EugeneCarlo/Mushsynth-8_voice_drone_synth/How_it_works/README.MD

Hello.<br>
I made a polyphonic synth from improvised and cheap parts.<br>
It came out musically enough.<br>
Now I am often asked to build, but I'm not interested, so I posted the entire project for self-assembly.

Mushsynth-8

This is a polyphonic subtractive synthesizer for 8 voices.

Each voice is a monophonic subtractive synthesizer, parallelly combined into a common low-pass filter and has on board:

An oscillator with adjustable pitch and switchable waveform (Triangle/Square)<br>
An LFO with speed and depth controls to modulate the pitch of the oscillator.<br>
An envelope generator with attack and decay speed adjustments to control the VCA.<br>
Individual volume control for each voice.<br>
To control the envelope generator, capacitive sensors are used, which can operate in two modes (hold or momentary).<br>
Eight such voices are combined into a single low-pass filter and delay. I have also added an independent knob for adding white noise.<br>
Each voice can be controlled by CV/GATE which is set to each voice.<br>

Technicial Specifications:
+ 8 Polyphony
+ 8 Analog VCO
+ 2 Waveforms VCO
+ 8 Analog LFO (Speed/Depth)
+ 8 Analog Envelope (Attack/Decay)
+ 8 Analog VCA
+ 8 Channel Mixer
+ 8 Sensor touch panel
+ 1 White noise generator
+ 1 Analog LP Filter
+ 1 Delay PT2399
+ 8 CV inputs
+ 8 GATE inputs
+ Can work with adapter 9V
+ Mono Output (6.3mm jack)
+ Circuit banding area (bread board)

The synthesizer consists of 3 PCB on which all components are placed.<br>
The circuit is completely analog, so a lot of components came out (about 750)

Mushsynth-8

Below is some information about the circuit that I used.

For sensors, I used TTP223 microcircuits, because they are affordable and can work in two modes (hold and momentary)<br>
You can set the sensitivity of the capacitors<br>
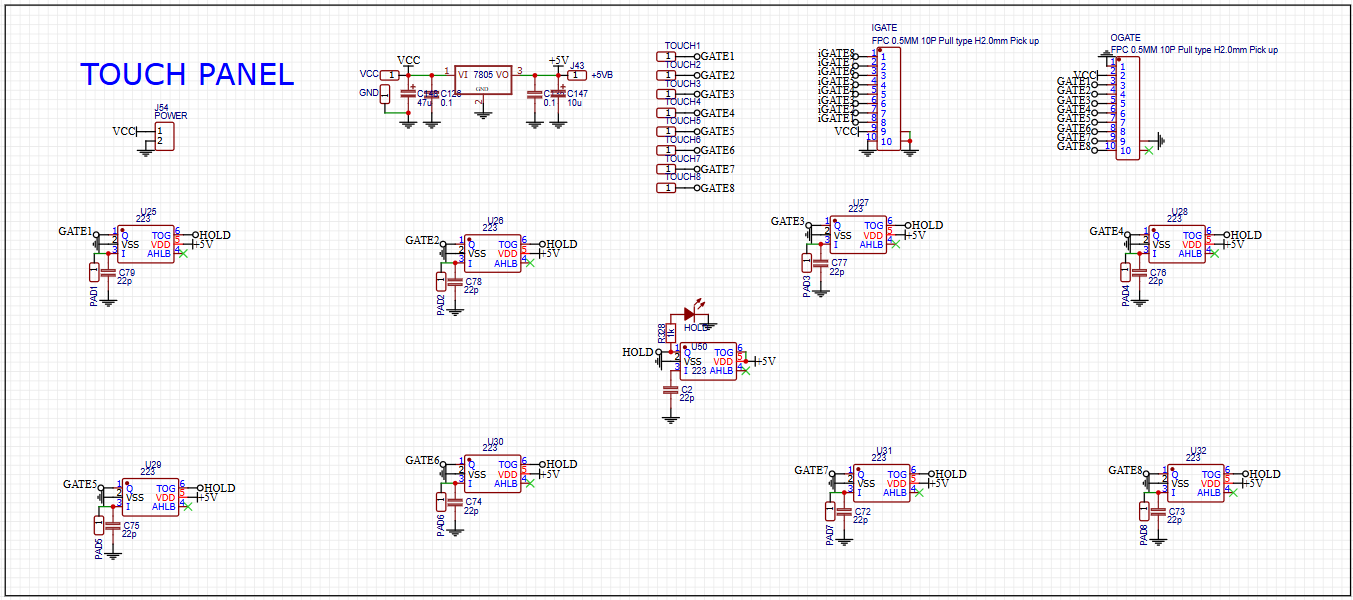
[picture p5: Schematic/Touch.png]
Touch


The VCO was made on one OpAmp LM358, according to some of the simplest schemes from the Internet, but it works well and gives out two signals (a triangle and a square)

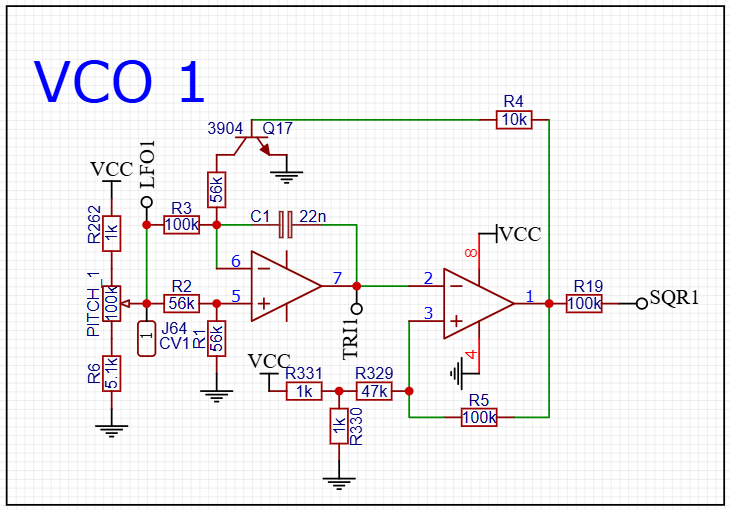
[picture p6: Schematic/VCO.png]
VCO

To modulate the pitch, I made an LFO.<br>
I also used LM358 and added a speed indication through a transistor.

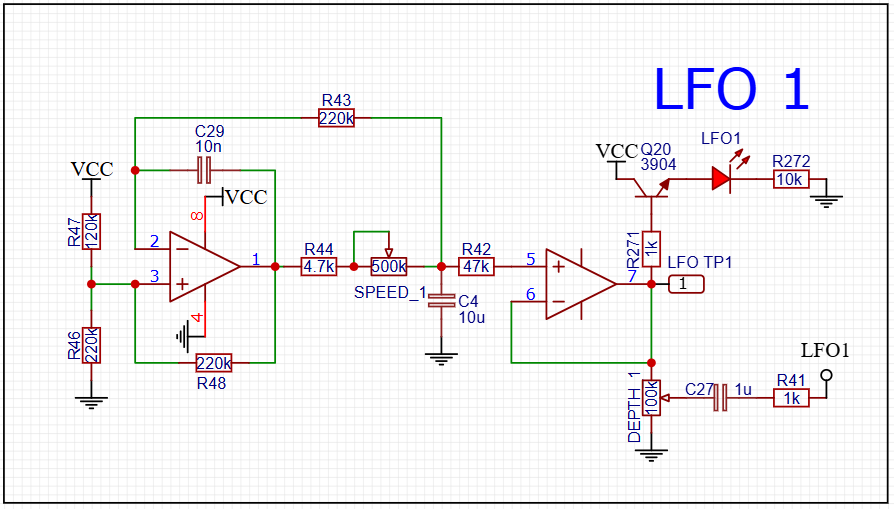
[picture p7: Schematic/LFO.png]
LFO

Then the signal is sent to the VCA, I could not find a suitable working example that would work well from + 9v, so I had to experiment, but I was satisfied with the result, this circuit works stably.<br>
I used lm13700 because they are clear to me and work in different voltage ranges.

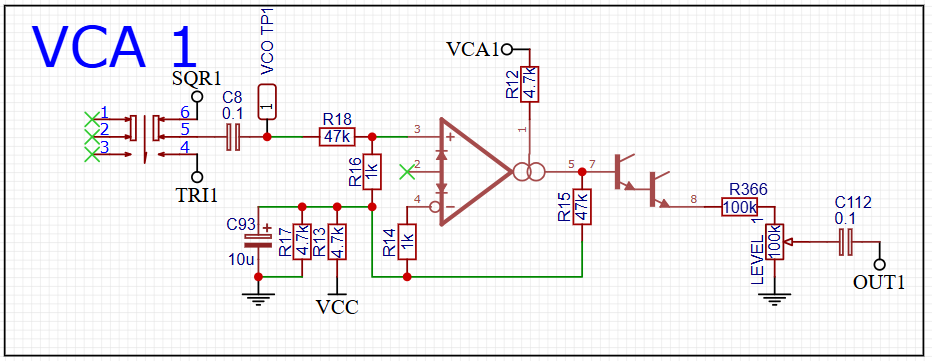
[picture p8: Schematic/VCA.png]
VCA

To control the VCA, I needed an envelope generator, I also decided to use the lm358 and made a fairly classic circuit, but I used only a single-polar supply.<br>
I also added an indication of operation through a transistor, as in the LFO.

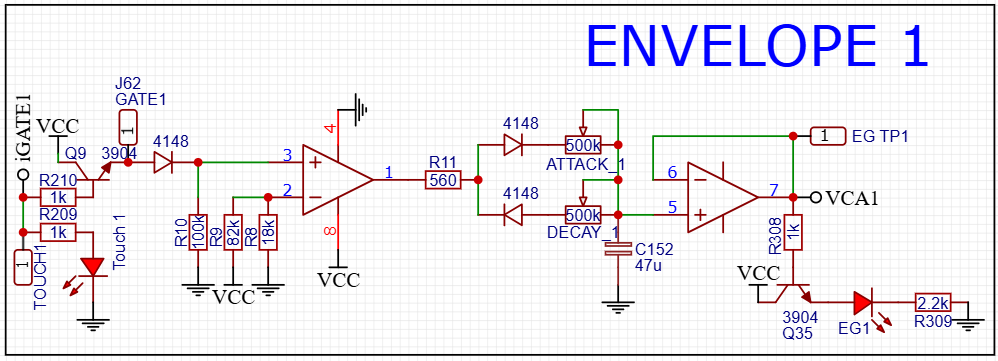
[picture p9: Schematic/ENVELOPE.png]
Envelope

I made 8 of these heads and decided that something was missing.<br>
Therefore, I decided to add a white noise generator, I took a circuit from a noise toaster from mfos.<br>
I liked the 2n5551 transistors, they are cheap, affordable and always stable noise.

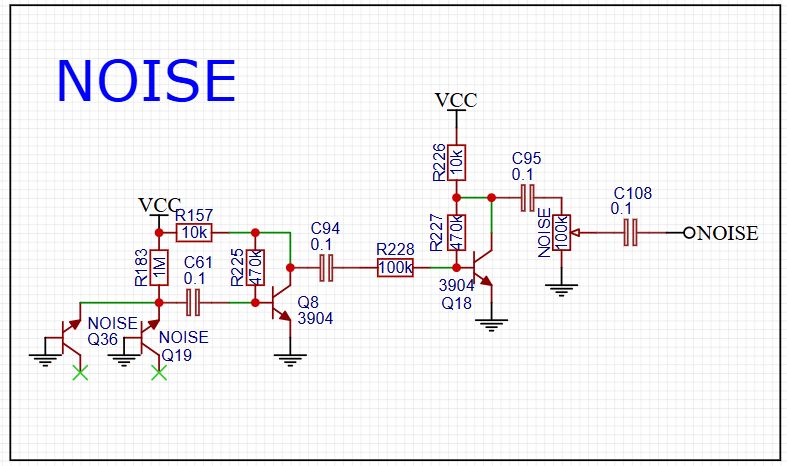
[picture p10: Schematic/NOISE.png]
Noise

It still wasn't enough for me.<br>
Then I decided to add a filter and a delay.<br>
I used quite popular schemes, I think many of them collected them.

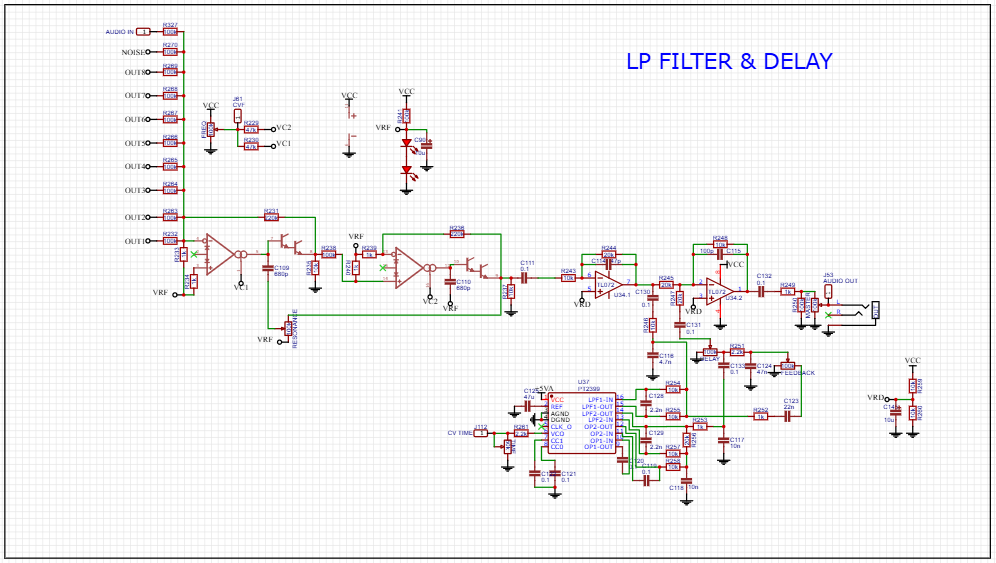
[picture p11: Schematic/VCF_Delay.png]
VCF_Delay

I liked the result and many musicians were interested in the project, so I decided to share it with you.

I connected MIDI only to version 1.3 and used an Arduino Nano, 6N137 and several transistors to reduce the current load on the Arduino.
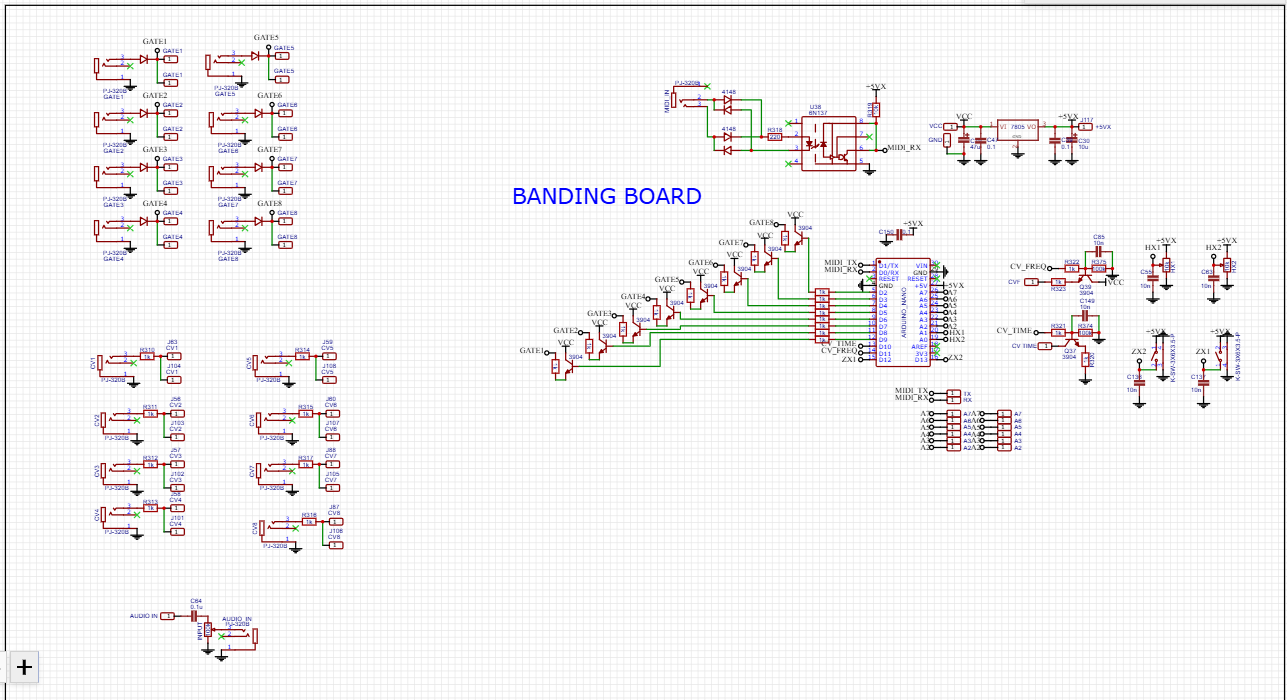
[picture p12: Schematic/MIDI.png]
MIDI


**I sent out about 10 build kits and everyone did it just like me, even the most beginners.<br>
The assembly is not difficult, but it took me about 15 hours.**
