EugeneCarlo/Mushsynth-8_voice_drone_synth/Image/DNO.png

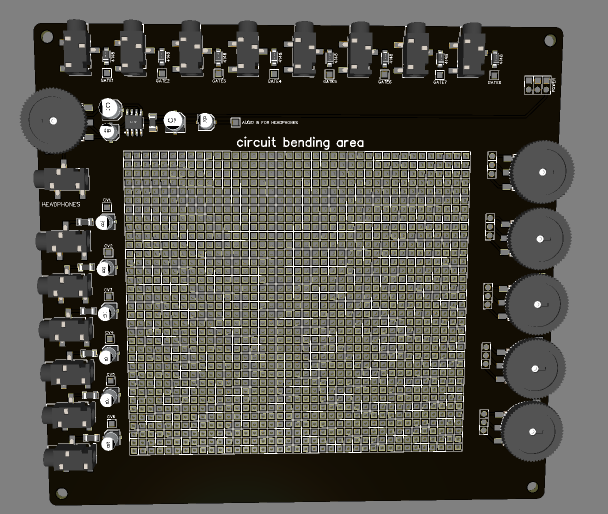
Image/DNO.png
