EugeneCarlo/Mushsynth-8_voice_drone_synth/Image/Front.jpg

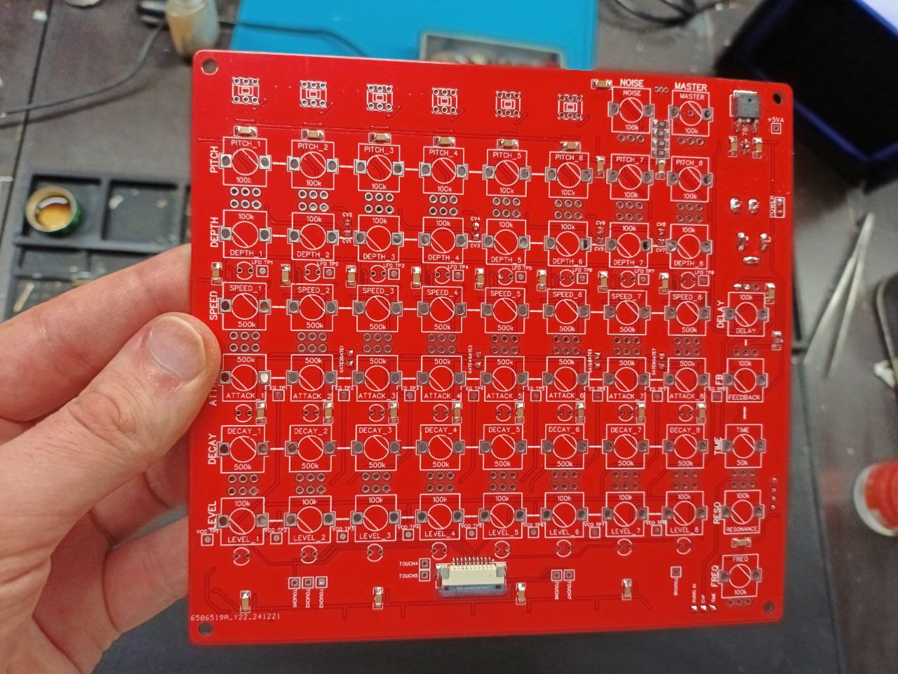
Image/Front.jpg
