EugeneCarlo/Mushsynth-8_voice_drone_synth/Image/Panel.jpg

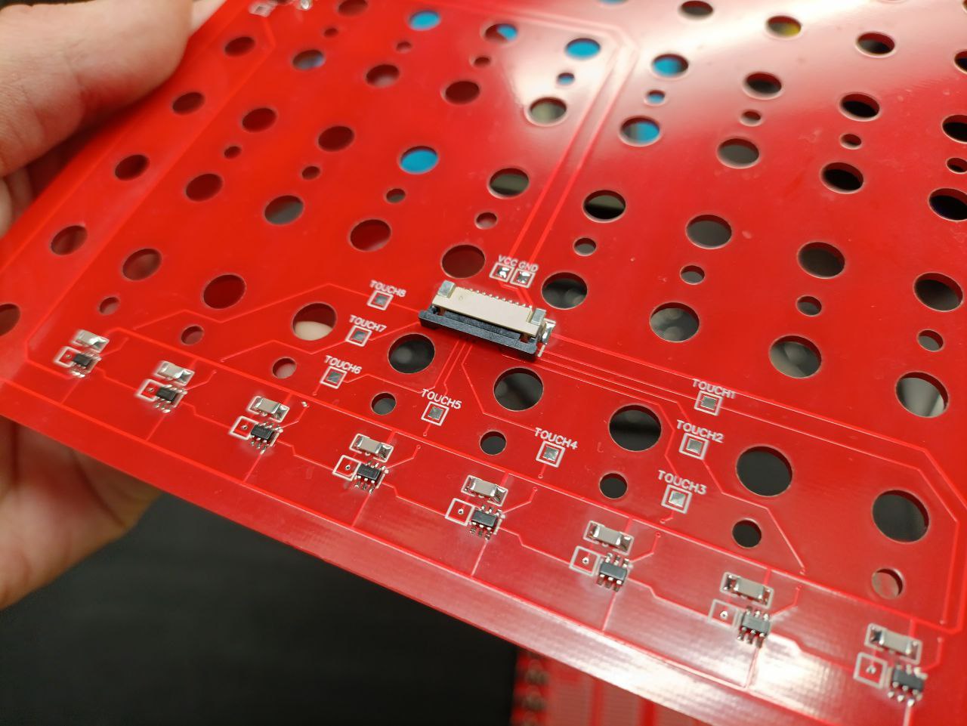
Image/Panel.jpg
