EugeneCarlo/Mushsynth-8_voice_drone_synth/Image/Panel.png

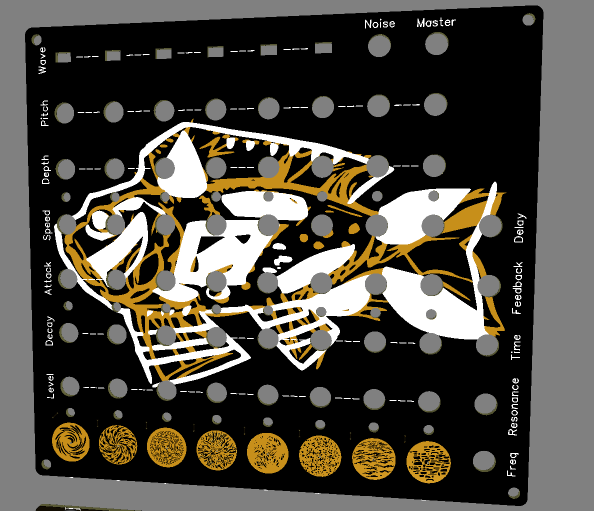
Image/Panel.png
