EugeneCarlo/Mushsynth-8_voice_drone_synth/Image/PCB B.png

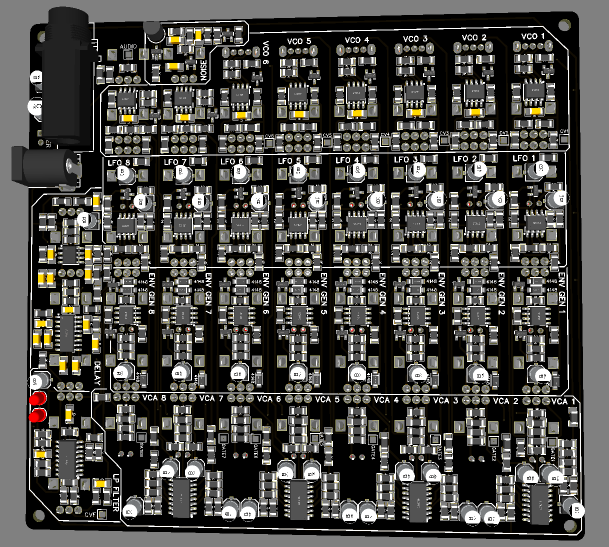
Image/PCB B.png
