EugeneCarlo/Mushsynth-8_voice_drone_synth/Image/PCB T.png

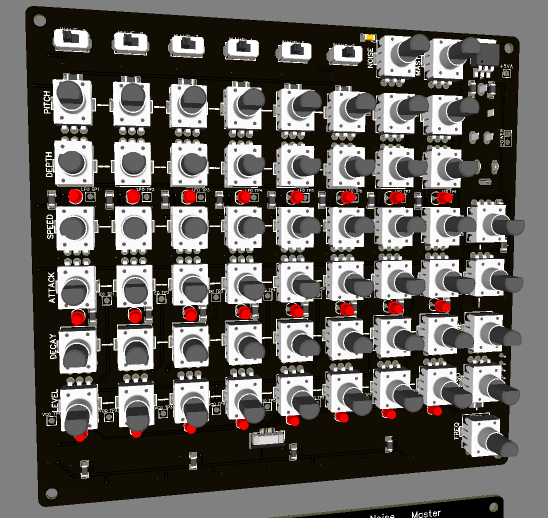
Image/PCB T.png
