EugeneCarlo/Mushsynth-8_voice_drone_synth/Image/SMD.jpg

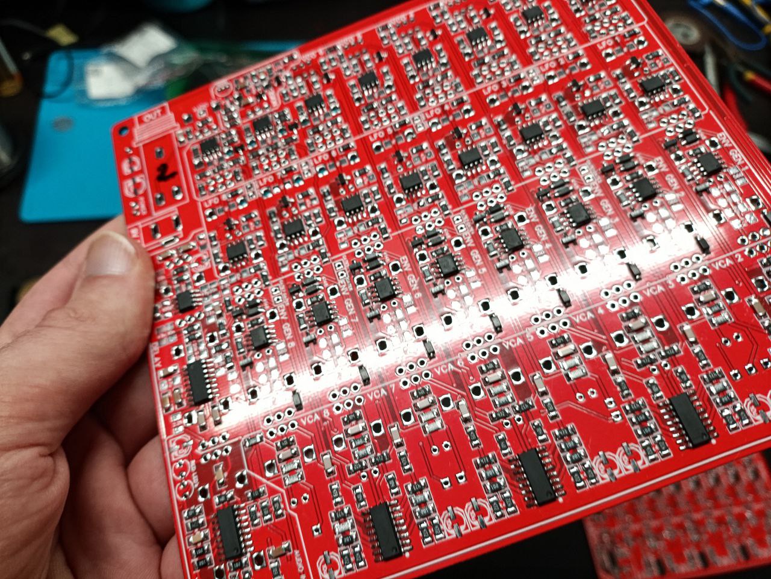
Image/SMD.jpg
