EugeneCarlo/Mushsynth-8_voice_drone_synth/Schematic/DELAY.png

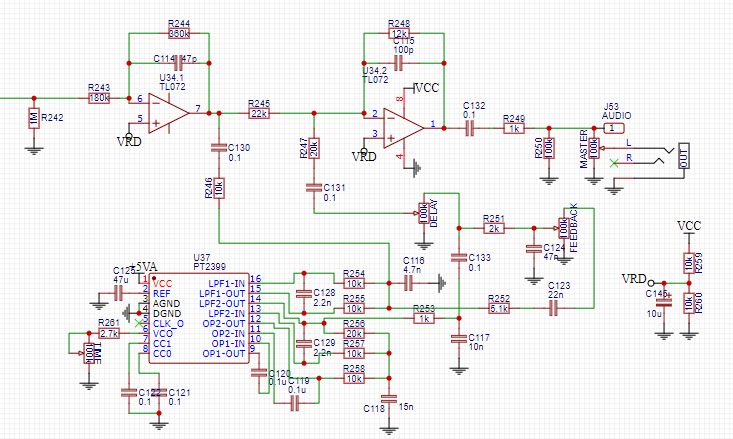
Schematic/DELAY.png
