EugeneCarlo/Mushsynth-8_voice_drone_synth/Schematic/LP FILTER.png

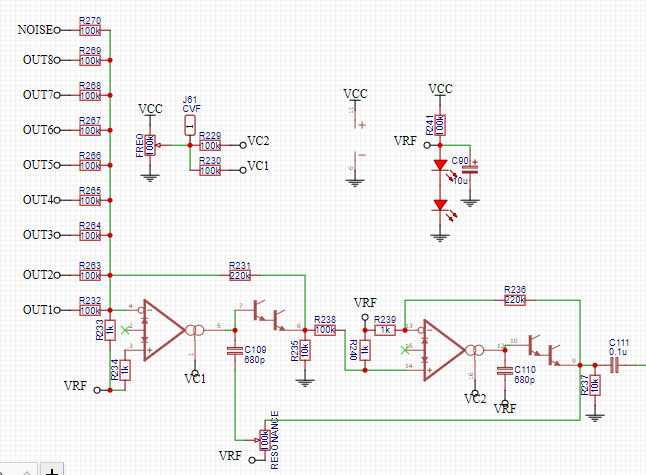
Schematic/LP FILTER.png
