EugeneCarlo/Mushsynth-8_voice_drone_synth/Schematic/Power.png

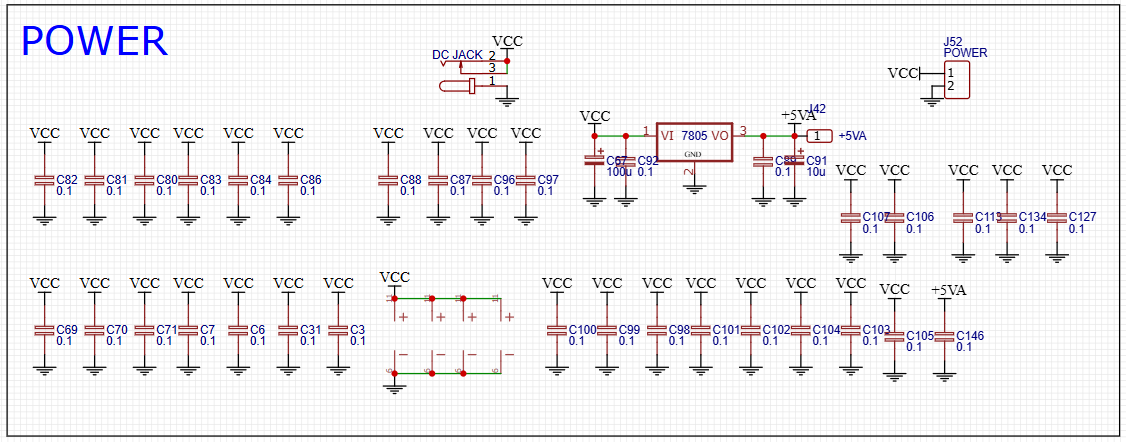
Schematic/Power.png
