EugeneCarlo/Mushsynth-8_voice_drone_synth/Schematic/Sensor.png

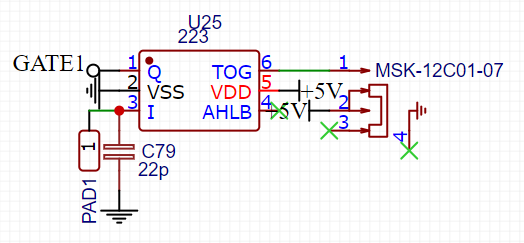
Schematic/Sensor.png
