EugeneCarlo/Mushsynth-8_voice_drone_synth/BOM/README.MD

### [Download xlsx](https://github.com/EugeneCarlo/Mushsynth-8_voice_drone_synth/raw/main/BOM/Mushsynth-8%20BOM.xlsx)

## Резисторы

| Номинал | Описание | Количество |
| --- | --- | --- |
| 220 | R1206 | 1 шт |
| 560 | R1206 | 8 шт |
| 1k | R1206 | 116 шт |
| 2.2k | R1206 | 18 шт |
| 4.7k | R1206 | 24 шт |
| 5.1k | R1206 | 8 шт |
| 10k | R1206 | 30 шт |
| 18k | R1206 | 8 шт |
| 20k | R1206 | 4 шт |
| 47k | R1206 | 34 шт |
| 56k | R1206 | 24 шт |
| 82k | R1206 | 8 шт |
| 100k | R1206 | 54 шт |
| 120k | R1206 | 8 шт |
| 220k | R1206 | 26 шт |
| 470k | R1206 | 2 шт |
| 1M | R1206 | 1 шт |

## Конденсаторы

| Номинал | Описание | Количество |
| --- | --- | --- |
| 22p | C1206 | 9 шт |
| 47p | C1206 | 1 шт |
| 100p | C1206 | 1 шт |
| 680p | C1206 | 2 шт |
| 2.2n | C1206 | 2 шт |
| 4.7n | C1206 | 1 шт |
| 10n | C1206 | 22 шт |
| 22n | C1206 | 3 шт |
| 47n | C1206 | 1 шт |
| 0.1 | C1206 | 68 шт |
| 1u | C1206 | 8 шт |
| 47u | C1206 | 17 шт |
| 10u | CAP-D4.0x | 13 шт |
| 47u | CAP-D4.0x | 2 шт |
| 100u | CAP-D5.0x | 1 шт |

## Диоды/Транзисторы/Микро

| Номинал | Описание | Количество |
| --- | --- | --- |
| 1N4148 | SOD-123 | 36 шт |
| 2N3904 | SOT-23-3 | 44 шт |
| NOISE | TO-92 | 1 шт |
| L78M05 | DPAK | 3 шт |
| LM358 | SOIC-8 | 25 шт |
| LM13700 | SOIC-16 | 5 шт |
| PT2399 | SOP-16 | 1 шт |
| TTP223 | SOT-23-6 | 9 шт |
| 6N137 | DIP-8 | 1 шт |
| ARDUINO | ARDUINO | 1 шт |
| LED RED | 3mm (1.8v) | 2 шт |
| LED FLAT | 3mm (FLAT) | 25 шт |

## Гнезда и другое

| Номинал | Описание | Количество |
| --- | --- | --- |
| 50k | R0904-N | 1 шт |
| 100k | R0904-N | 30 шт |
| 500k | R0904-N | 24 шт |
| 10k | R1001B | 2 шт |
| 100k | R1001B | 1 шт |
| SWITCH | 5.8X5.8 LC | 6 шт |
| SWITCH | K-SW-3X6X | 2 шт |
| JACK 3.5 | PJ-320B | 18 шт |
| OUT | ST-008 | 1 шт |
| DC JACK | Barrel | 1 шт |
| FPC | 10P-P1.00 | 2 шт |
| FFC | 10P-P1.00 | 1 шт |
| Стойки | 8mm | 4 шт |
| Стойки | 15mm | 4 шт |
| Винты | Звезда | 4 шт |
| Гайки | С фиксацией | 4 шт |
| PLS | Удлиненные | 9 шт |
| PLS | Удлиненные | 1 шт |
| HLS |  | 9 шт |
| HLS |  | 1 шт |
| Кнобы |  | 55 шт |
