EugeneCarlo/Mushsynth-8_voice_drone_synth/Schematic/Schematic_Mushsynth-8-(1.3-ver).pdf

# R18 TRI1

# POWER

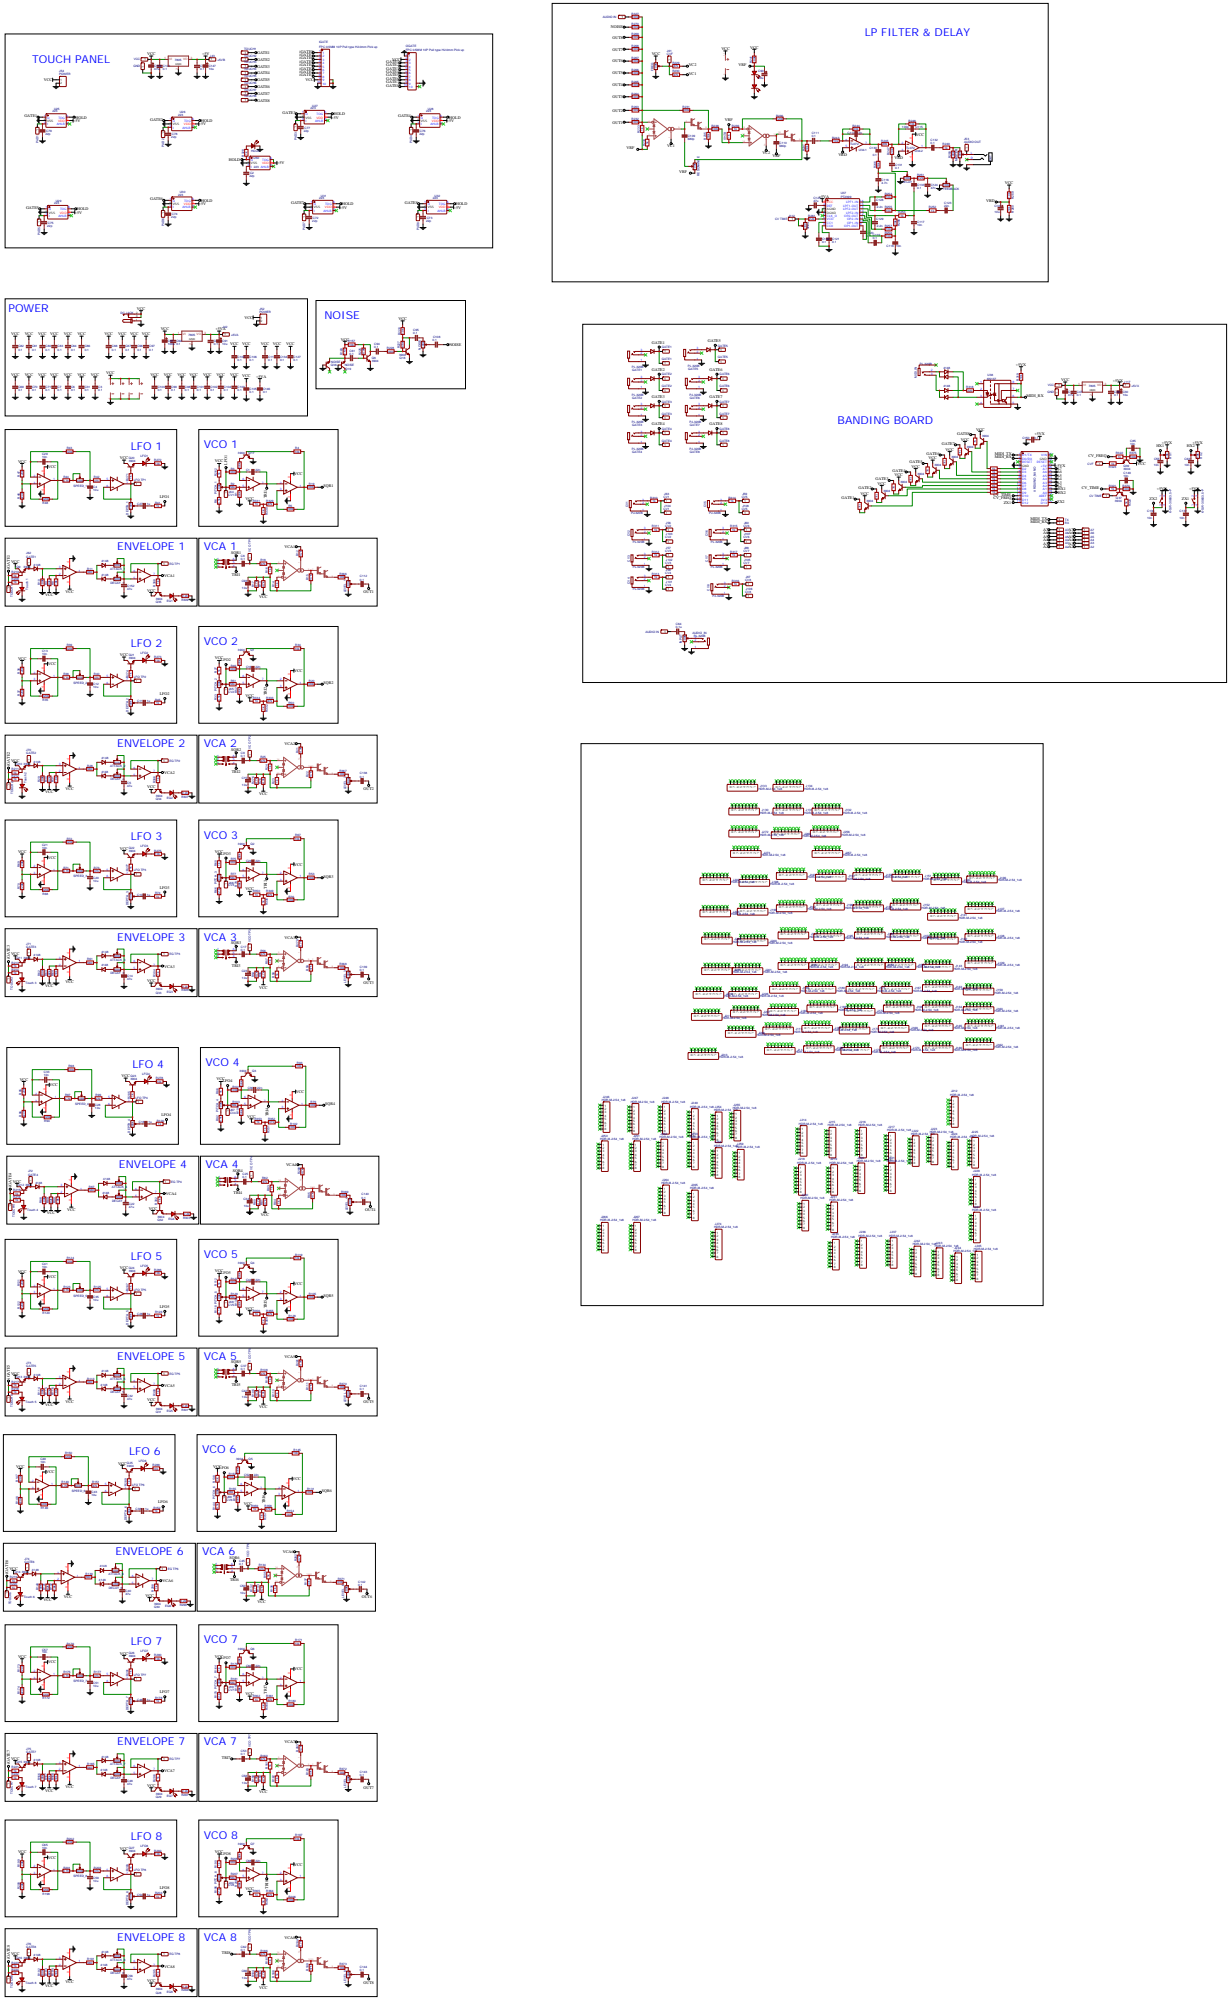
[picture p24: page 1]

VCO TP1 1 VCO TP2 1 VCO TP3 1 VCO TP4 1 VCO TP5 1 VCO TP6 1 VCO TP7 1 VCO TP8 1
