EugeneCarlo/Mushsynth-8_voice_drone_synth/(threads)

Thread 1 (2023-02-28):

Вопрос по сорсингу компонентов и изготовлению плат

zemuro, 2023-02-28:
Привет! Классный проект, очень профессионально реализован. Хотел спросить не совсем по теме. Где вы заказываете платы и компоненты? У меня в неспешной работе проект небольшого модульного микшера для кассетных плееров, синтов и прочего такого, думаю, где элементную базу брать и платы заказать, чтоб недорого. Спасибо!

EugeneCarlo, 2023-02-28:
Добрый день, спасибо, приятно.
Я не занимаюсь этим профессионально и это просто хобби.

Платы заказываю на JLCPCB или PCBWAY, в зависимости от параметров платы
бывает дешевле, выбираю по цене.
Качество одинаковое как правило.

Большинство деталей типа резисторов или конденсаторов заказываю на али, с
микросхемами сложнее, стараюсь покупать оригинальные, часто хорошие цены
бывают в электронщике, но не брезгую и али.

В синтезаторе "рыба" специально использовал самые доступные и безпроблемные
комплектующие, почти все заказал на али, в BOM файле стараюсь прикреплять
ссылки на детали в тех магазинах где заказывал, но али это всегда лотерея.

Так же у нас собрался довольно большой чат в тг с классными участниками,
которые очень сильно помогают проектам своими знаниями, опытом и стараемся
делить ссылками на проверенные магазины.

Заходите тоже пообщаться, у нас уютно)
https://t.me/sborkasobaka

вт, 28 февр. 2023 г., 17:42 Ruslan Mazavin ***@***.***>:

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
