EugeneCarlo/Mushsynth-8_voice_drone_synth/(commit log)

2023-01-02 Обновленице
2025-10-12 Revise README and BOM for Mushsynth-8 project; added detailed specifications, updated component list, and included new images and schematics for version 1.3. Introduced a new How It Works document an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
